zebauman/ECEN404-2026SP-Wireless-Real-Time-Motor-System/Presentations/404 status update 1.pptx

## Team 26: DC Motor Rotation Control Bi-Weekly Update 1

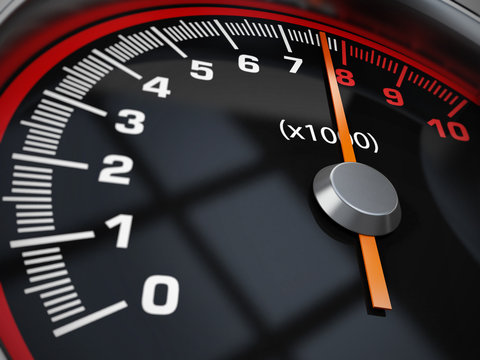
[picture p1: figure]

Zachary Bauman, Terrance Smith, Rodene Corpuz-Roxas, Josiah Thompson
Sponsor: Aniruddha Datta
TA: TBD

## Project Summary

Problem statement:
- Motors are everywhere, even in hazardous areas. And all motors need to be controlled even when an operator is not physically present.
Our Solution:
- Create a custom DC motor controller that is safe and intuitive for the user.

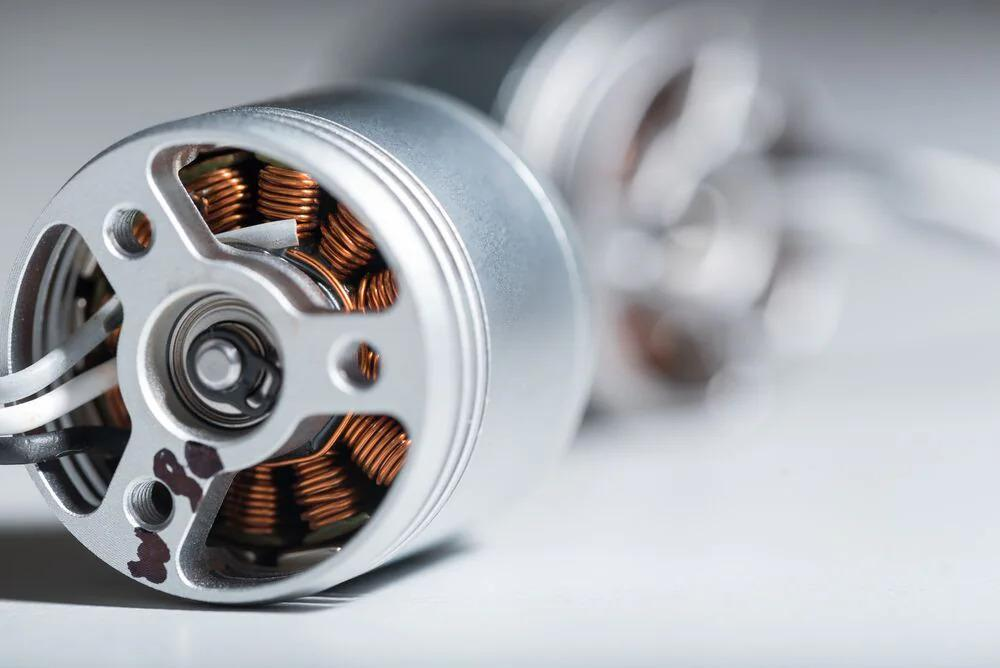
[picture p2: figure]

## System Overview

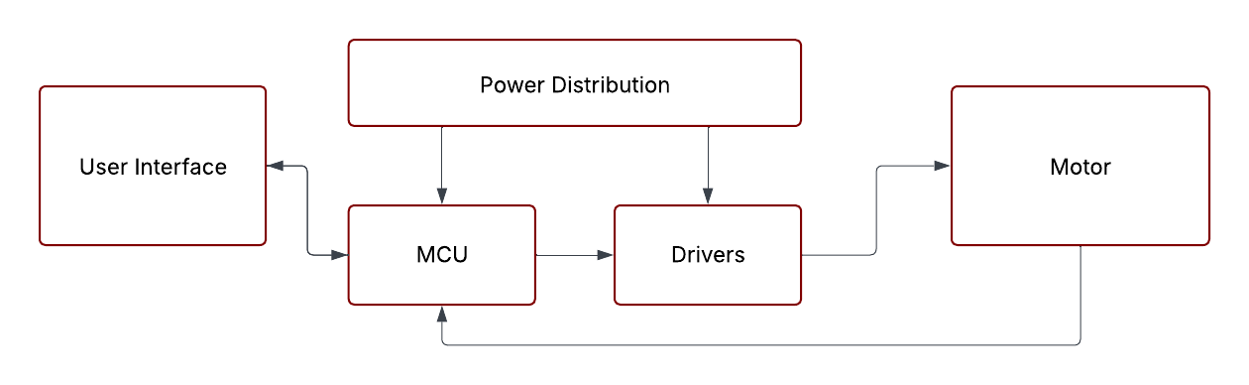
[picture p3: figure]

Rodene Corpuz-Roxas

Bluetooth

Zachary Bauman

Terrance Smith

Josiah Thompson

Notes: Cloud server and database

## Major Project Changes for 404

- Decreased the scope of the project to only the DC motor
- Main control of only one motor

Notes: Cloud server and database

## Project Timeline

Notes: Cloud server and database

## User Interface Subsystem Zachary Bauman

Accomplishments since 403 4 hrs of effort | Ongoing progress/problems and plans until the next presentation
Source code documentation Increased the interface accessibility and user-friendliness | Bonding/Authorized Access Firebase Integration MCU Bootloader Over-the-air Firmware Updates

## User Interface Subsystem Zachary Bauman

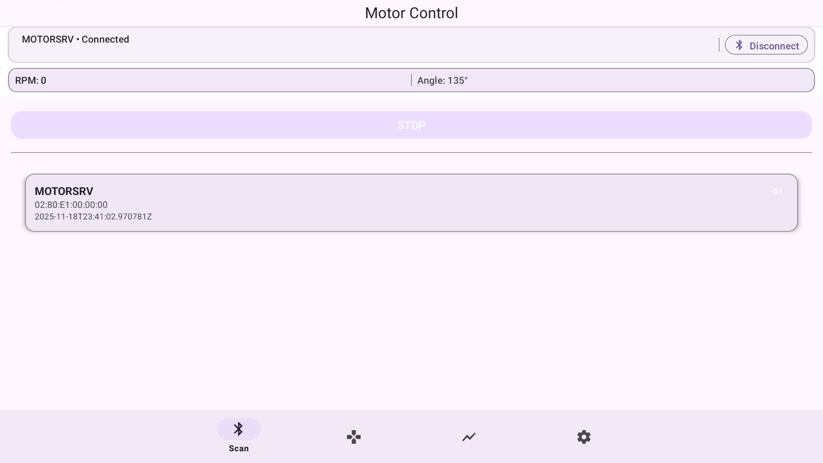
[picture p4: figure]
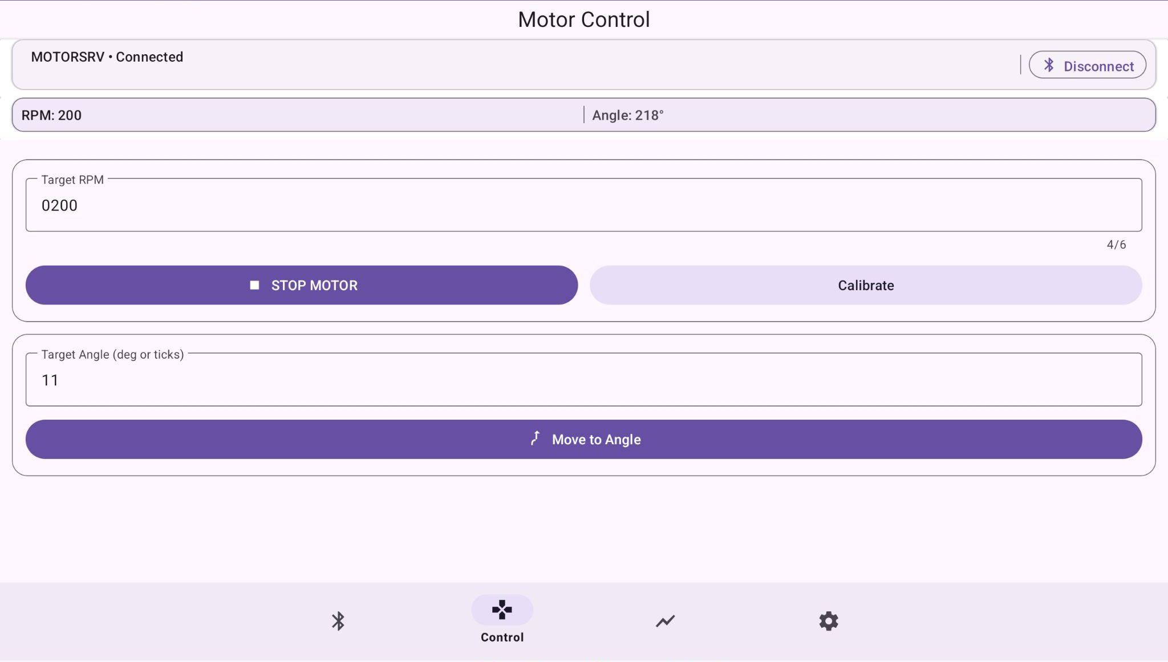
[picture p5: figure]
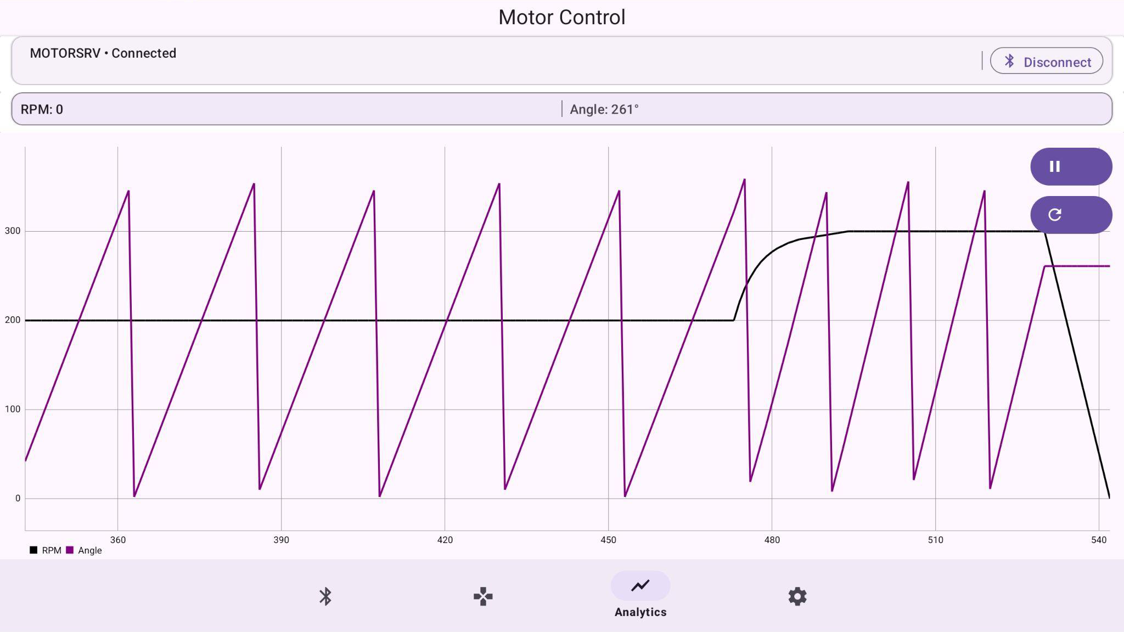
[picture p6: figure]

## Control Algorithm Josiah Thompson

Accomplishments since 403 2 hrs of effort | Ongoing progress/problems and plans until the next presentation
MCU research Existing code review | Add coverage for edge cases in the algorithm Add bidirectional control Research position control requirements

## Control Algorithm Josiah Thompson

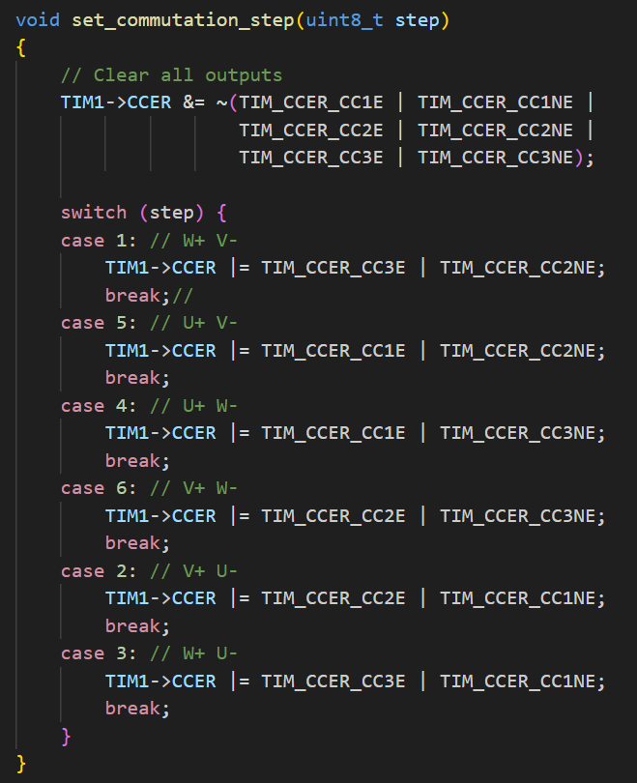
[picture p7: figure]
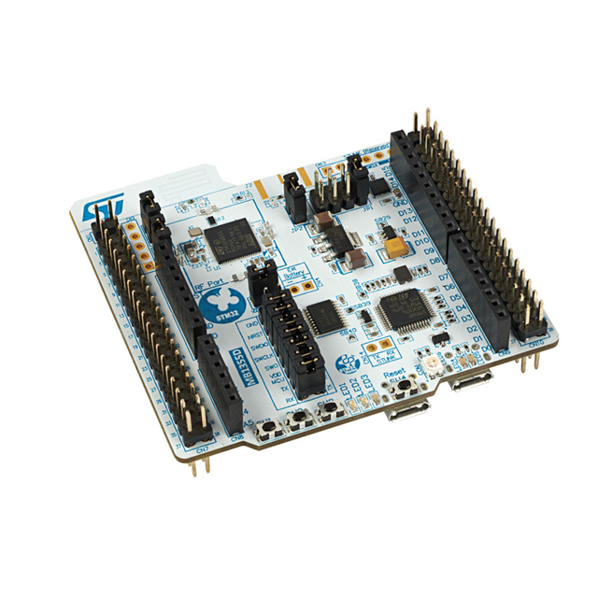
[picture p8: figure]

## Custom driver/controller Terrance Smith

Accomplishments since 403 3 hours | Ongoing progress/problems and plans until the next presentation
-Diagnosed the component error | -Fix exact pcb component to allow NMOS to fully activate -Add buck converter to pcb design

## Custom Controller/Driver Terrance Smith

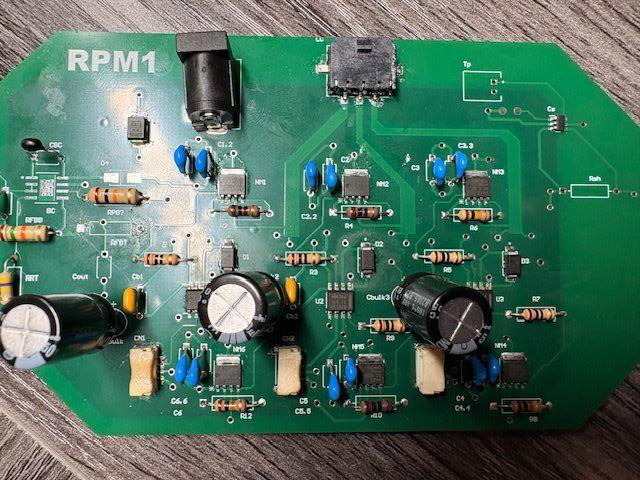
[picture p9: figure]

- MOSFETS are becoming source followers.
- Bootstrap capacitors are not charging up.

## Custom Driver/Encoder Subsystem Overview

403 Deliverables
- Converts PWM outputs into readable signal for motor response
- Able to produce all 6-steps of motor control
- Floating Phase receives and records the back-EMF from motor
- PWM phase holds and charges Boot Capacitor

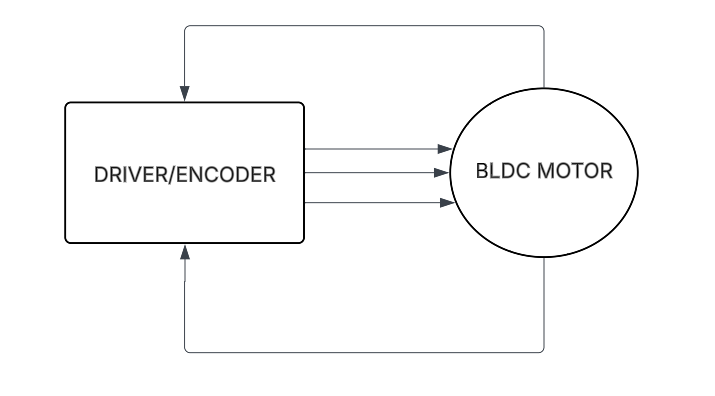
[picture p10: figure]

## Power Rodene

- PCB is tasked with converting wall input into output power supply for control system

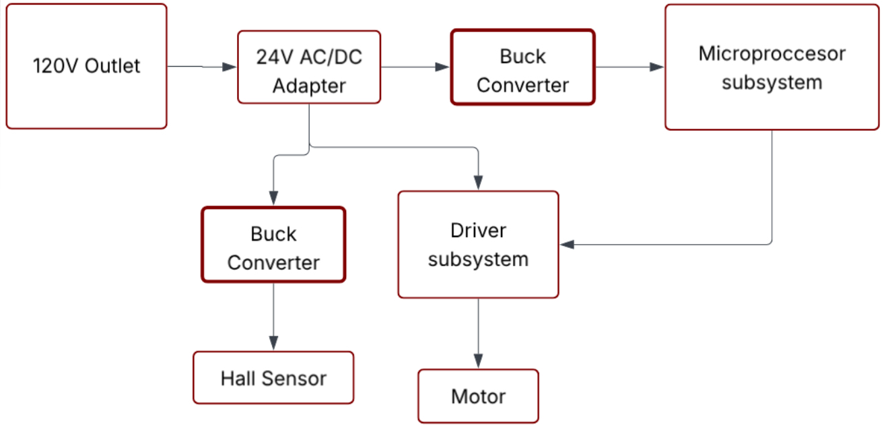
[picture p11: figure]

## Power Rodene

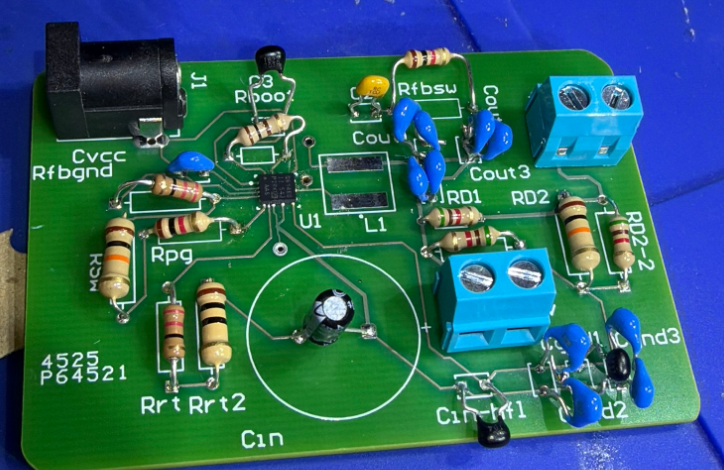
[picture p12: figure]

## Power Rodene Corpuz-Roxas

Accomplishments since 403 2 hours | Ongoing progress/problems and plans until the next presentation
Currently have a non-functional PCB, but circuit schematic passes simulation expectations Diagnosed where PCB failed | Redesign PCB ground (trace widths/placements) Reorder PCB and respective components

## Parts Ordering Status

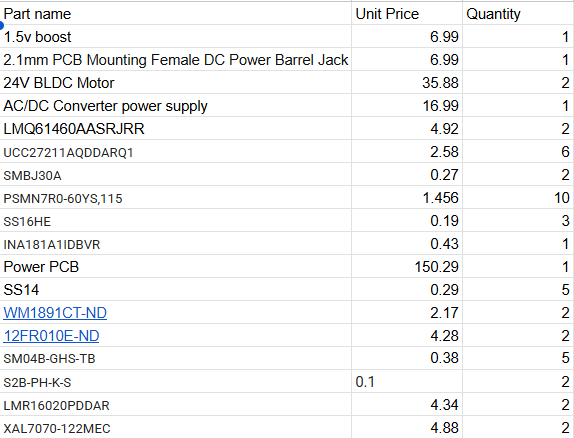
[picture p13: figure]

Inventory check for remaining spare parts. PCB orders will be placed by friday along with any necessary parts needed for circuits. Desired day to receive parts will be Wednesday-Thursday.

Notes: Michelle

## Execution & Plan

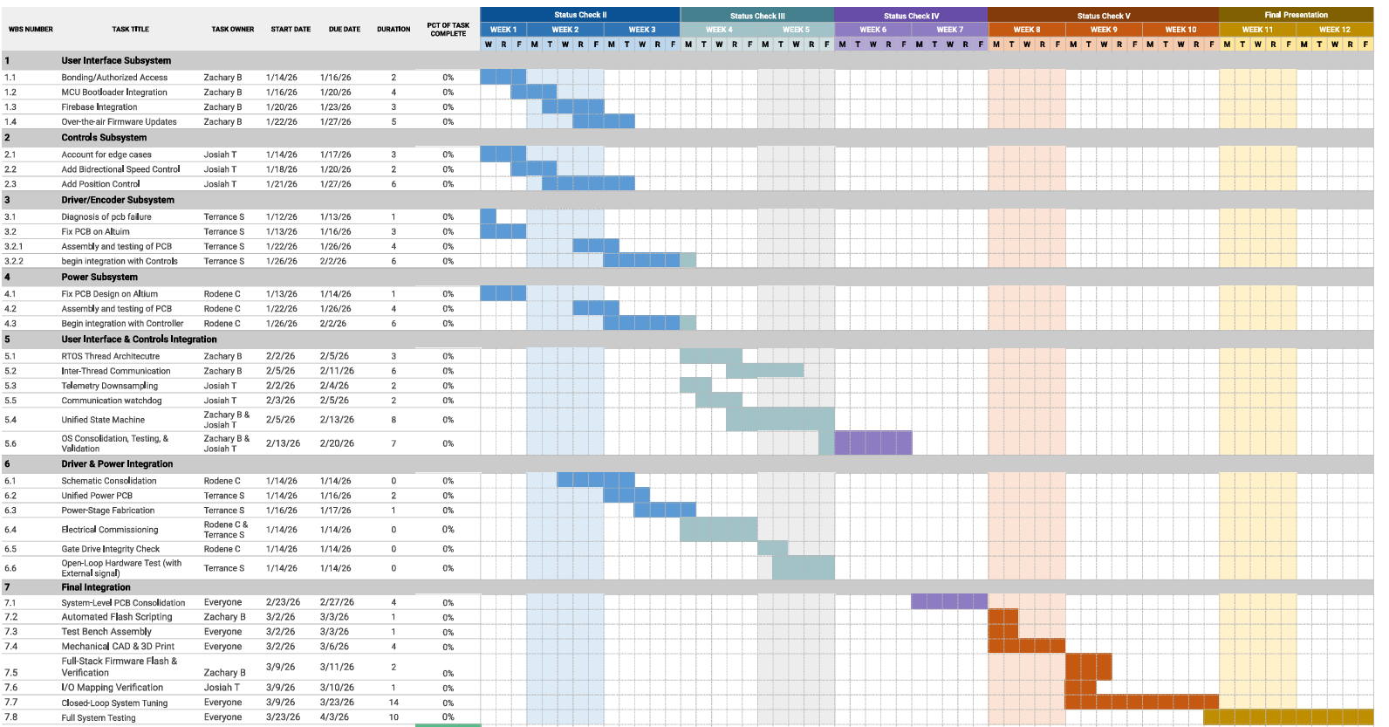
[picture p14: figure]

Notes: Michelle

## Slide 18

Team 26: RPM1
Thanks & Gig’em

‹#›
