zebauman/ECEN404-2026SP-Wireless-Real-Time-Motor-System/Test Results/poster_p_vs_pi_comparison.png

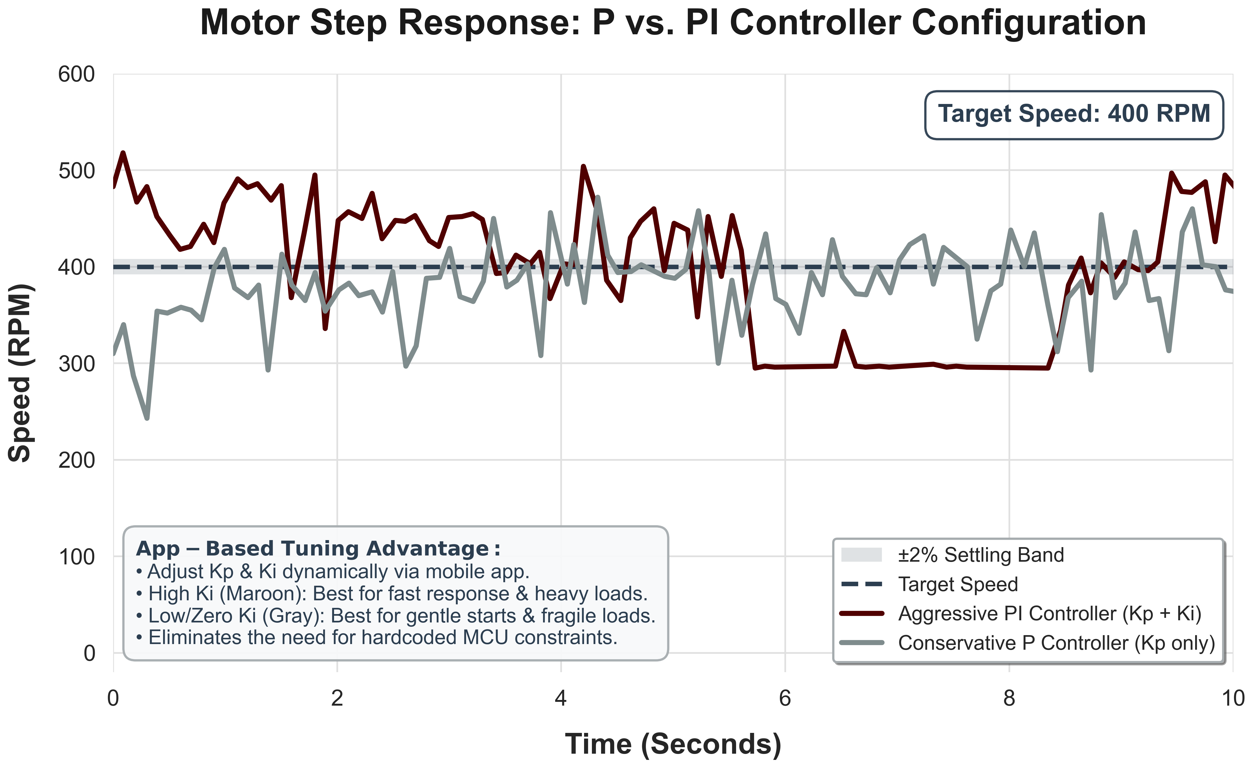
Test Results/poster_p_vs_pi_comparison.png
