zebauman/ECEN404-2026SP-Wireless-Real-Time-Motor-System/power&housing/component housing.SLDPRT

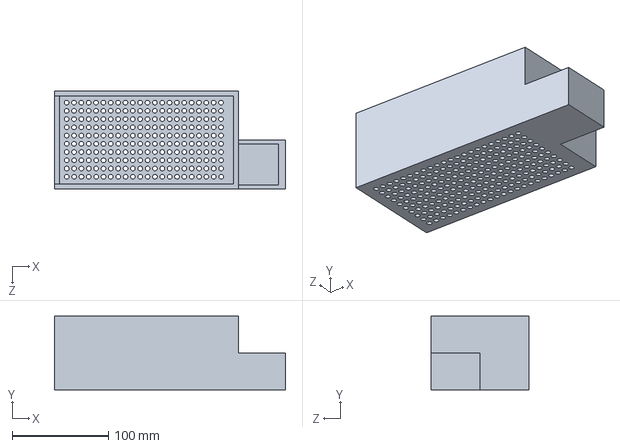
[picture p28: CAD file, 2026-04-23]
power&housing/component housing.SLDPRT
239.5 x 76.2 x 101.6 mm
