zebauman/ECEN404-2026SP-Wireless-Real-Time-Motor-System/power&housing/component-housing-pt2.STL

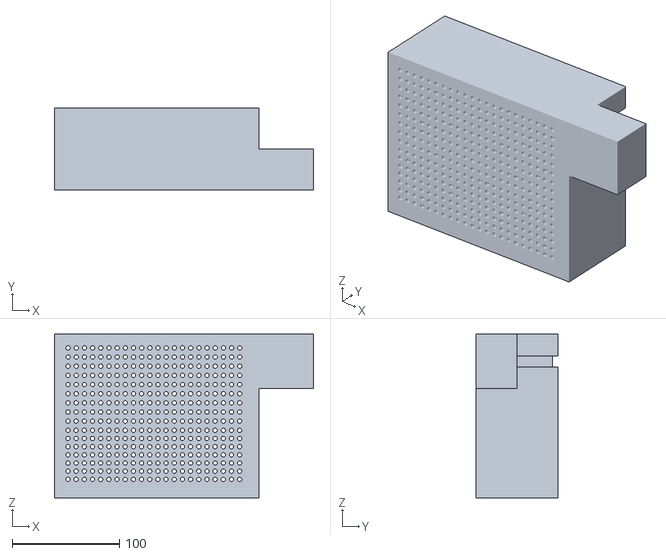
[picture p29: CAD file, 2026-04-23]
power&housing/component-housing-pt2.STL
241.4 x 76.2 x 152.4
