zebauman/ECEN404-2026SP-Wireless-Real-Time-Motor-System/power&housing/lid-for-comphouse.STL

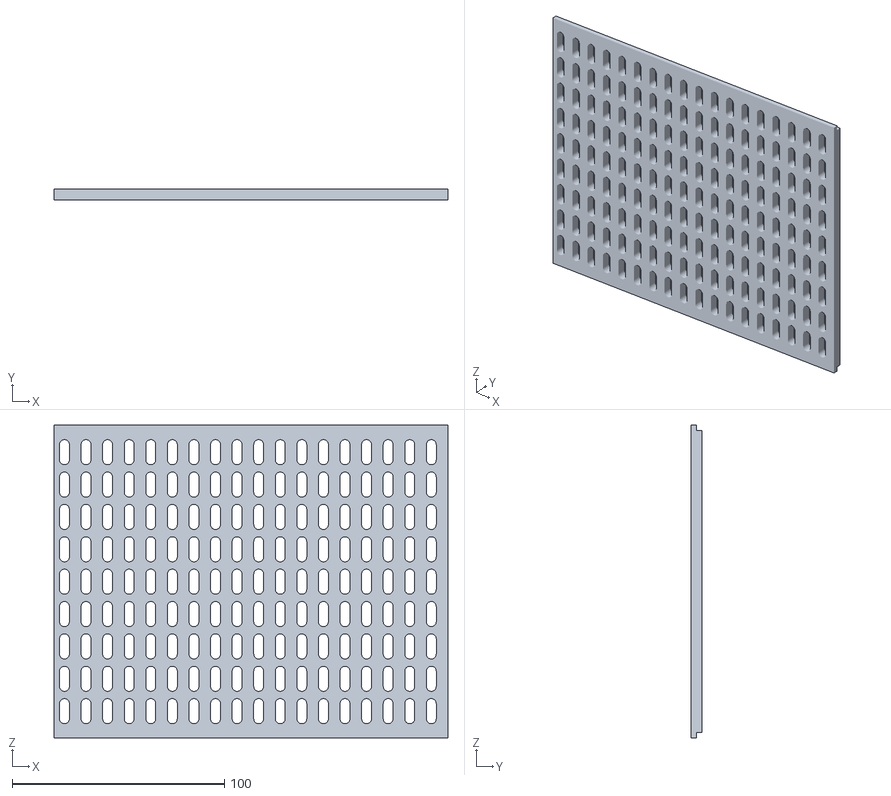
[picture p30: CAD file, 2026-04-23]
power&housing/lid-for-comphouse.STL
185.5 x 5.08 x 147.2
