zebauman/ECEN404-2026SP-Wireless-Real-Time-Motor-System/(list of files, cad)

Other CAD files:
power&housing/component housing.STL
