zebauman/ECEN404-2026SP-Wireless-Real-Time-Motor-System/Test Results/Aggressive_PI_Controller.csv

Timestamp(ms) | RPM | Angle(deg) | State | Flags
1776639852359 | 0 | 0 | 0 | 0
1776639855481 | 483 | 0 | 1 | 0
1776639855569 | 518 | 0 | 1 | 0
1776639855692 | 467 | 0 | 1 | 0
1776639855782 | 483 | 0 | 1 | 0
1776639855871 | 452 | 0 | 1 | 0
1776639855990 | 432 | 0 | 1 | 0
1776639856079 | 418 | 0 | 1 | 0
1776639856171 | 421 | 0 | 1 | 0
1776639856289 | 444 | 0 | 1 | 0
1776639856380 | 425 | 0 | 1 | 0
1776639856470 | 466 | 0 | 1 | 0
1776639856593 | 491 | 0 | 1 | 0
1776639856681 | 482 | 0 | 1 | 0
1776639856769 | 486 | 0 | 1 | 0
1776639856891 | 469 | 0 | 1 | 0
1776639856982 | 484 | 0 | 1 | 0
1776639857071 | 368 | 0 | 1 | 0
1776639857186 | 435 | 0 | 1 | 0
1776639857282 | 495 | 0 | 1 | 0
1776639857374 | 336 | 0 | 1 | 0
1776639857490 | 448 | 0 | 1 | 0
1776639857581 | 457 | 0 | 1 | 0
1776639857702 | 450 | 0 | 1 | 0
1776639857793 | 476 | 0 | 1 | 0
1776639857882 | 429 | 0 | 1 | 0
1776639858000 | 448 | 0 | 1 | 0
1776639858088 | 447 | 0 | 1 | 0
1776639858176 | 453 | 0 | 1 | 0
1776639858304 | 427 | 0 | 1 | 0
1776639858386 | 421 | 0 | 1 | 0
1776639858476 | 451 | 0 | 1 | 0
1776639858595 | 452 | 0 | 1 | 0
1776639858693 | 455 | 0 | 1 | 0
1776639858777 | 449 | 0 | 1 | 0
1776639858902 | 393 | 0 | 1 | 0
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
