zebauman/ECEN404-2026SP-Wireless-Real-Time-Motor-System/Test Results/Conservative_P _Controller.csv

Timestamp(ms) | RPM | Angle(deg) | State | Flags
1776639747715 | 0 | 0 | 1 | 0
1776639747836 | 310 | 0 | 1 | 0
1776639747929 | 340 | 0 | 1 | 0
1776639748017 | 287 | 0 | 1 | 0
1776639748138 | 243 | 0 | 1 | 0
1776639748228 | 354 | 0 | 1 | 0
1776639748320 | 352 | 0 | 1 | 0
1776639748441 | 358 | 0 | 1 | 0
1776639748532 | 355 | 0 | 1 | 0
1776639748625 | 345 | 0 | 1 | 0
1776639748739 | 399 | 0 | 1 | 0
1776639748829 | 418 | 0 | 1 | 0
1776639748920 | 378 | 0 | 1 | 0
1776639749040 | 368 | 0 | 1 | 0
1776639749135 | 381 | 0 | 1 | 0
1776639749219 | 293 | 0 | 1 | 0
1776639749342 | 413 | 0 | 1 | 0
1776639749431 | 381 | 0 | 1 | 0
1776639749550 | 365 | 0 | 1 | 0
1776639749639 | 394 | 0 | 1 | 0
1776639749729 | 354 | 0 | 1 | 0
1776639749851 | 376 | 0 | 1 | 0
1776639749941 | 383 | 0 | 1 | 0
1776639750029 | 370 | 0 | 1 | 0
1776639750148 | 374 | 0 | 1 | 0
1776639750240 | 353 | 0 | 1 | 0
1776639750331 | 395 | 0 | 1 | 0
1776639750449 | 297 | 0 | 1 | 0
1776639750541 | 318 | 0 | 1 | 0
1776639750632 | 388 | 0 | 1 | 0
1776639750750 | 389 | 0 | 1 | 0
1776639750840 | 419 | 0 | 1 | 0
1776639750932 | 369 | 0 | 1 | 0
1776639751050 | 364 | 0 | 1 | 0
1776639751141 | 385 | 0 | 1 | 0
1776639751232 | 450 | 0 | 1 | 0
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
