zebauman/ECEN404-2026SP-Wireless-Real-Time-Motor-System/Test Results/lazy_system_professional_centered.png

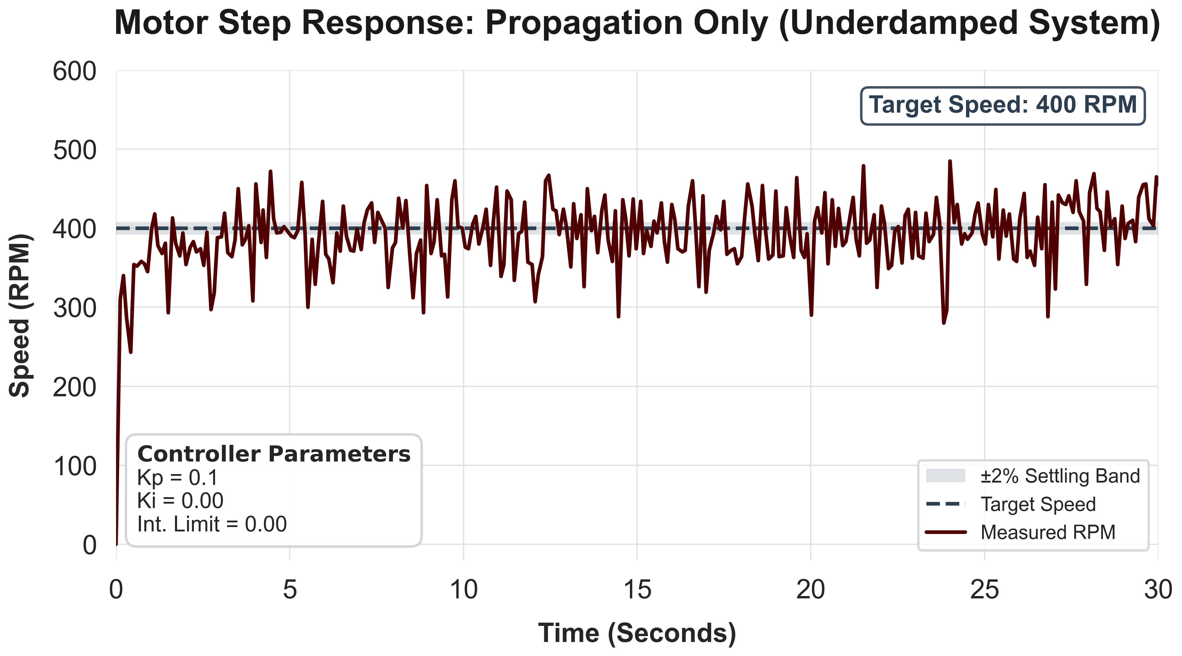
Test Results/lazy_system_professional_centered.png
