zebauman/ECEN404-2026SP-Wireless-Real-Time-Motor-System/Test Results/p_vs_pi_controller_comparison.png

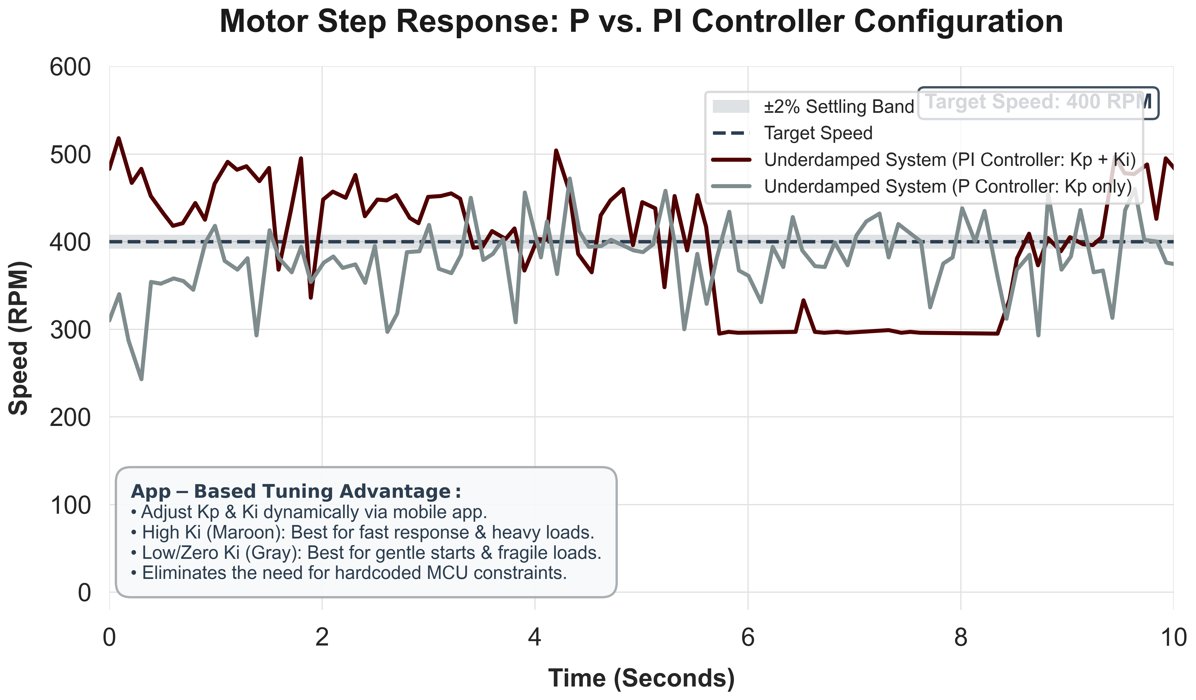
Test Results/p_vs_pi_controller_comparison.png
