zebauman/ECEN404-2026SP-Wireless-Real-Time-Motor-System/Test Results/system_comparison_0_to_10s.png

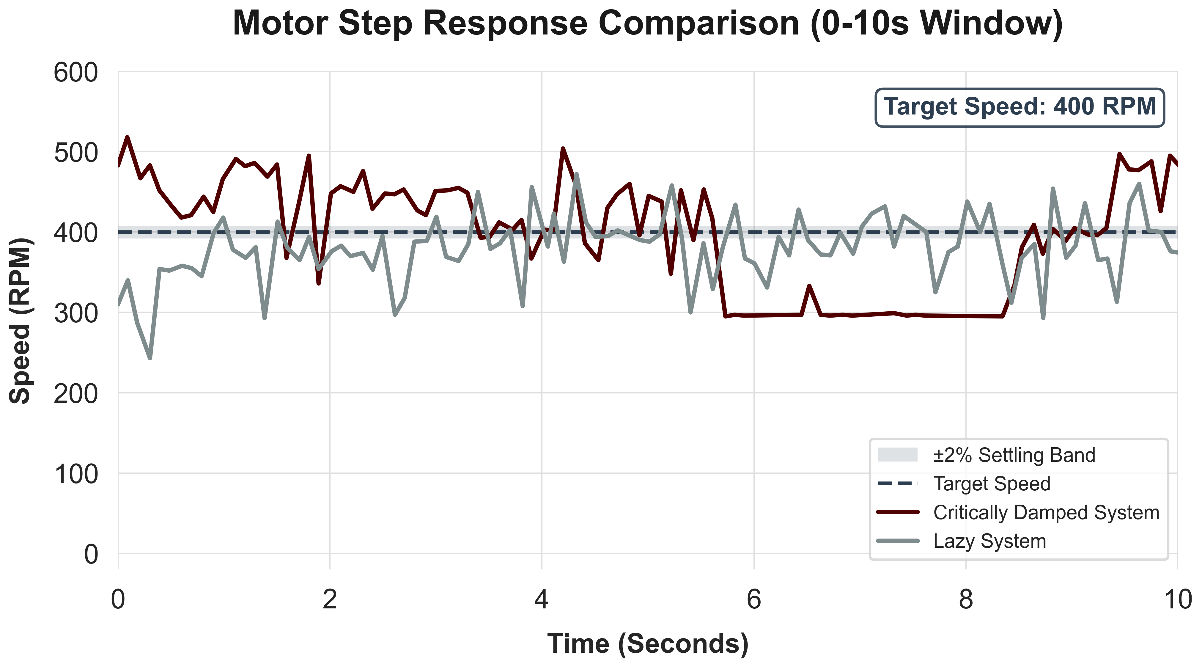
Test Results/system_comparison_0_to_10s.png
