zebauman/ECEN404-2026SP-Wireless-Real-Time-Motor-System/(list of files, drawings)

Other design files:
Custom Motor Controller/Driver_Controller.PrjPcb
Custom Motor Controller/Driver_Controller.SchDoc
Microcontroller_PCB/MCU/MCU Schematic.SchDoc.schdoc
Microcontroller_PCB/MCU/MCU_PCB.PcbDoc.pcbdoc
Microcontroller_PCB/RF_module_Project/antenna.PcbLib
Microcontroller_PCB/RF_module_Project/antennaS.SchLib
Microcontroller_PCB/RF_module_Project/PCB1.PcbDoc
Microcontroller_PCB/RF_module_Project/Rf schematic.SchDoc
Microcontroller_PCB/RF_module_Project/RF_module_Project.PrjPcb
power&housing/404.PrjPcb
power&housing/404DoublesidePCB.PcbDoc
power&housing/404pcb5v.SchDoc
power&housing/MCU Schematic.SchDoc
power&housing/MCU_PCB.PcbDoc
