zebauman/ECEN404-2026SP-Wireless-Real-Time-Motor-System/(commit log)

2026-03-04 bldc_driver_sim.c is updated and fixed to reflect the current motor control logic and files. Kconfig has a MOTOR_SIM config for the developer to config bldc simulation or the actual bldc_driver on bu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
    [bldc_driver.c, bldc_driver_sim.c, main.c]
2026-03-04 bluetooth.c: changed the initial watchdog logic to only start to kick when the first heartbeat is received from the android device instead of kicking on connect. motor.h- added flag when the motor st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
    [bluetooth.c, bluetooth.h, main.c, motor.c, motor.h, motor_control.c]
2026-03-19 changed the logic of the bldc_driver to reflect the controls subsystem new commutation table and softstart up. The motor was able to spin clockwise from the android application's rpm input and reflec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
2026-04-17 Added a display to the user for the motor's live state and flags that get raised for the system
2026-04-17 added a telemetry logger to log the telemetry data and timestamp (rpm, angle, motor state, active flags) regarding the motor. The telemetry logger logs the data as it gets pushed from the Motor MCU t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
2026-04-17 UI changes regarding the live summary: motor state and active flags. settings: export logged telemetry data to csv
2026-04-17 updated firmware for the motor controller PI logic and other timer/devie constraints for hte integrated system and the stm32wb55 dev board
2026-04-19 migrated the BLE motor command send logic to from the BLEManager.kt to BleMotorSession for better structure and organizationwith command priority and Bluetooth write type inside a FIFO BLE REQUEST QU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
2026-04-19 added the ability for the the user to change the PI controller constants: KI, KP, and the integral limit. Added the PI controls to the Control page. updated the BLE protocol to send the PI constants 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
2026-04-19 fixed issue with the shutdown command using the write type instead of the priority to issue the command to the ble queue
    [BleMotorSession.kt]
2026-04-19 added to the MCU's ble protocol to take in kp, ki, and integral limit changes from the android UI from the user (flexible and not fixed PI controller through variable and user changable PI constraint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
    [bluetooth.c, bluetooth.h, motor_control.c, motor_control.h]
2026-04-19 changed the firmware to increase the speed of the PI commutation (PI freq. increased), significantly decreased the filter for the data, and changed other configurations for the motor logic firmwaresi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
2026-04-20 test results for the PI controller. Validation and backing for the PI controller where the motor step response is shwon and the advantages of using KI AND KP are shown. As well as the reason for allo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
    [Aggressive_PI_Controller.csv, Conservative_P _Controller.csv]
2026-04-20 Added the Custom Motor Controller Files and the Power Files to the Github - All of the files are centralized on this Github Repository now
    [404.PrjPcb, 404DoublesidePCB.PcbDoc, 404pcb5v.SchDoc, Driver_Controller.PrjPcb, Driver_Controller.SchDoc]
2026-04-22 Added microcontroller design and presentation files
    [MCU Schematic.SchDoc.schdoc, MCU_PCB.PcbDoc.pcbdoc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]
2026-04-23 Add power and housing files
    [404.PrjPcb, 404DoublesidePCB.PcbDoc, 404pcb5v.SchDoc, MCU Schematic.SchDoc, MCU_PCB.PcbDoc, component housing.SLDPRT, component housing.STL, component-housing-pt2.STL]
2026-04-23 filter changes: :
